hkr-ypt/iv-dcy/hardware/bom/iv_dcy-bom.csv

Reference | Value | Footprint | MPN | Qty
C1,C5 | 1uF | Capacitor_SMD:C_0603_1608Metric | 0603 1uF 16V X5R | 2
C2 | 4.7uF | Capacitor_SMD:C_0603_1608Metric | 0603 4.7uF 10V X5R | 1
C3,C4,C7 | 100nF | Capacitor_SMD:C_0603_1608Metric | 0603 100nF 16V X7R | 3
C6 | 10nF | Capacitor_SMD:C_0603_1608Metric | 0603 10nF 50V X7R | 1
D1 | green | LED_SMD:LED_0603_1608Metric | 0603 green LED | 1
J1 | USB_C_Receptacle | Connector_USB:USB_C_Receptacle_GCT_USB4105-xx-A_16P_TopMnt_Horizontal | GCT USB4105-GF-A | 1
J2 | SWD | Connector_PinHeader_1.27mm:PinHeader_2x05_P1.27mm_Vertical | Samtec FTSH-105-01-L-DV (or equivalent) | 1
R1,R2 | 5.1k | Resistor_SMD:R_0603_1608Metric | 0603 5.1k 1% | 2
R3 | 10k | Resistor_SMD:R_0603_1608Metric | 0603 10k 1% | 1
R4 | 1k | Resistor_SMD:R_0603_1608Metric | 0603 1k 1% | 1
SW1 | BOOT | Button_Switch_SMD:SW_SPST_B3U-1000P | Omron B3U-1000P | 1
U1 | STM32F042K6T6 | Package_QFP:LQFP-32_7x7mm_P0.8mm | STMicroelectronics STM32F042K6T6 | 1
U2 | MCP1700-3.3 | Package_TO_SOT_SMD:SOT-23 | Microchip MCP1700T-3302E/TT | 1
U3 | USBLC6-2SC6 | Package_TO_SOT_SMD:SOT-23-6 | STMicroelectronics USBLC6-2SC6 | 1
