hkr-ypt/iv-dcy/hardware/docs/iv_dcy-schematic.pdf

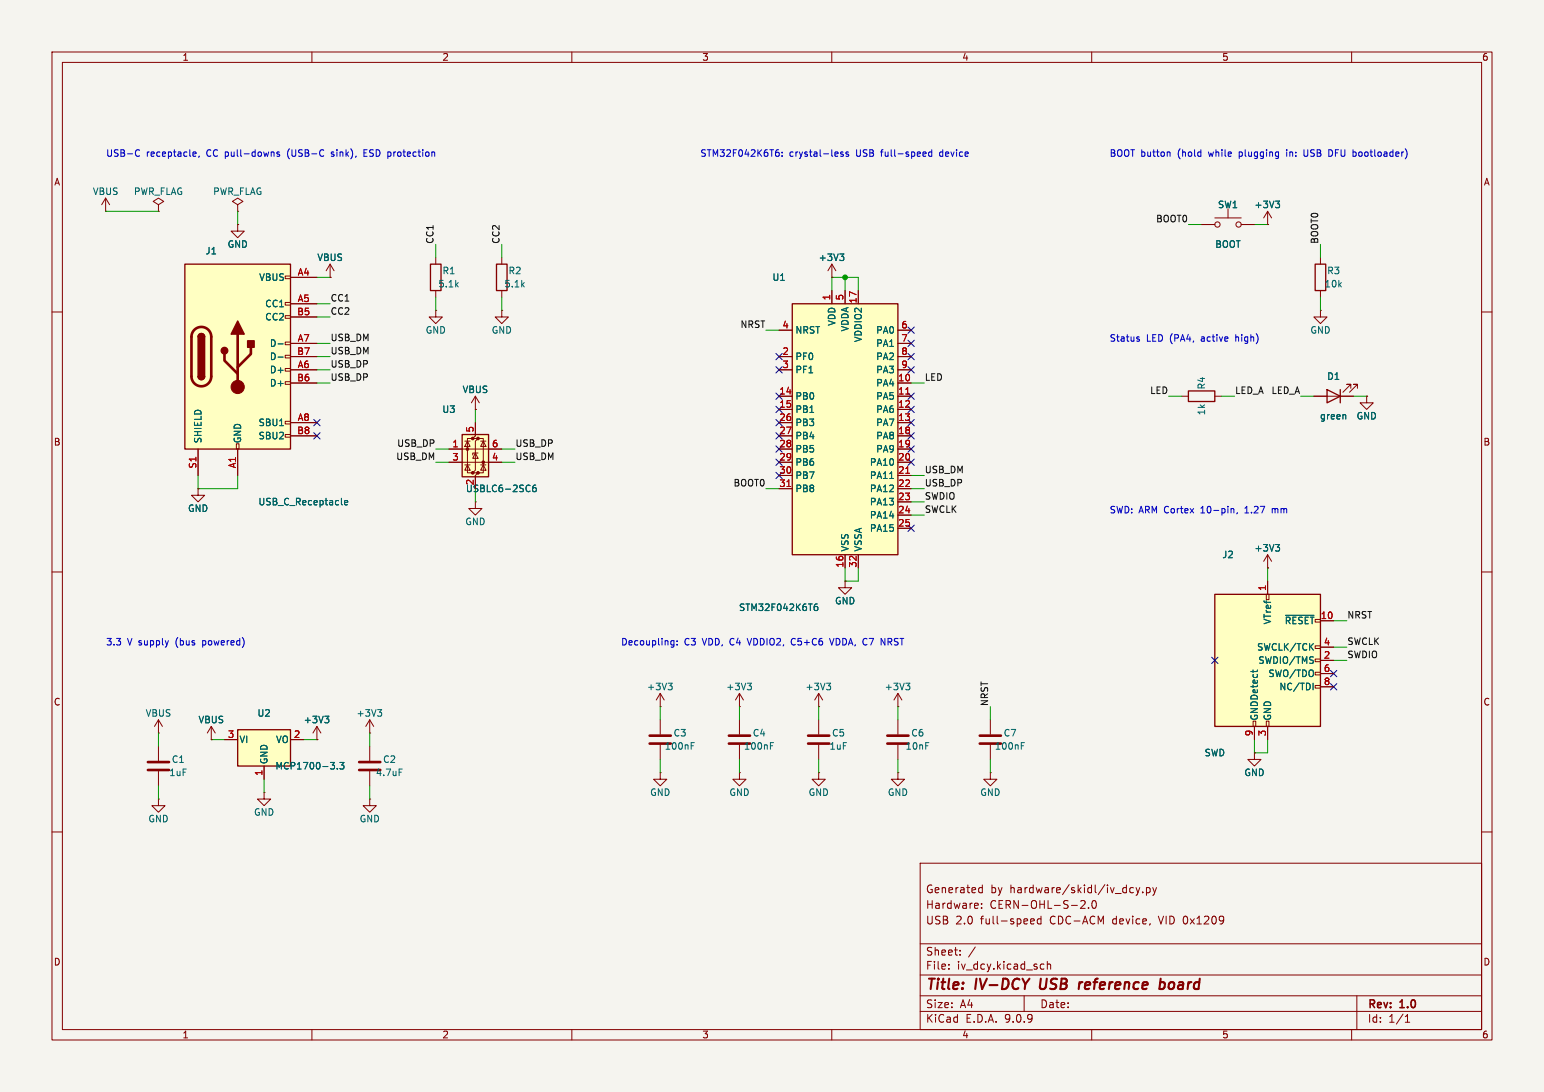
[picture p2: page 1]

3 ~{RESET}10 SWCLK/TCK 4 SWDIO/TMS 2 SWO/TDO 6 NC/TDI 8 GND

3 ~{RESET}10 SWCLK/TCK 4 SWDIO/TMS 2 SWO/TDO 6 NC/TDI 8

Id: 1/1 Title: IV-DCY USB reference board
