hkr-ypt/iv-dcy/hardware/kicad/iv_dcy.kicad_pcb

## KiCad design hardware/kicad/iv_dcy.kicad_pcb (2026-11-02)

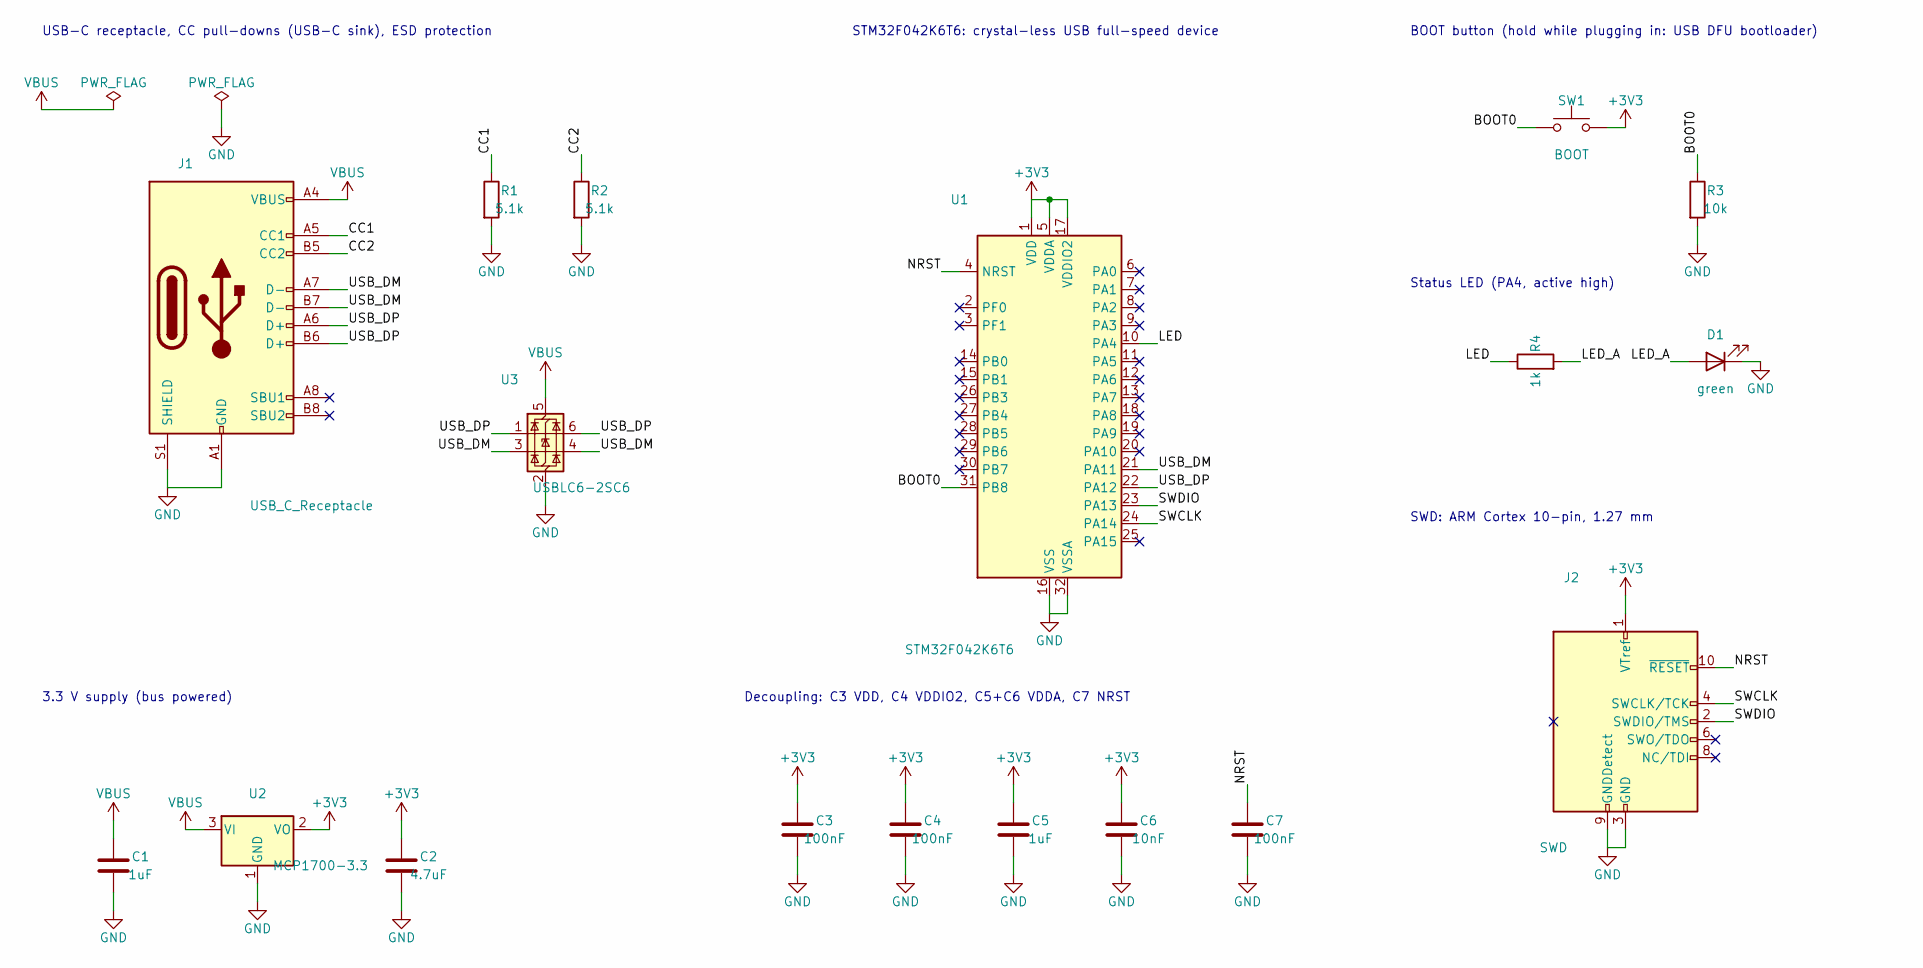
[picture p3: schematic iv_dcy.kicad_sch, IV-DCY USB reference board]

Parts:
C1, C5: 1uF; C_0603_1608Metric; MPN 0603 1uF 16V X5R
C2: 4.7uF; C_0603_1608Metric; MPN 0603 4.7uF 10V X5R
C3, C4, C7: 100nF; C_0603_1608Metric; MPN 0603 100nF 16V X7R
C6: 10nF; C_0603_1608Metric; MPN 0603 10nF 50V X7R
D1: green; LED_0603_1608Metric; MPN 0603 green LED
J1: USB_C_Receptacle; USB_C_Receptacle_GCT_USB4105-xx-A_16P_TopMnt_Horizontal; MPN GCT USB4105-GF-A
J2: SWD; PinHeader_2x05_P1.27mm_Vertical; MPN Samtec FTSH-105-01-L-DV (or equivalent)
R1, R2: 5.1k; R_0603_1608Metric; MPN 0603 5.1k 1%
R3: 10k; R_0603_1608Metric; MPN 0603 10k 1%
R4: 1k; R_0603_1608Metric; MPN 0603 1k 1%
SW1: BOOT; SW_SPST_B3U-1000P; MPN Omron B3U-1000P
U1: STM32F042K6T6; LQFP-32_7x7mm_P0.8mm; MPN STMicroelectronics STM32F042K6T6
U2: MCP1700-3.3; SOT-23; MPN Microchip MCP1700T-3302E/TT
U3: USBLC6-2SC6; SOT-23-6; MPN STMicroelectronics USBLC6-2SC6

Connections:
+3V3: C2.1, C3.1, C4.1, C5.1, C6.1, J2.1 (VTref), SW1.2, U1.1 (VDD), U1.5 (VDDA), U1.17 (VDDIO2), U2.2 (VO)
/BOOT0: R3.1, SW1.1, U1.31 (PB8)
/CC1: J1.A5 (CC1), R1.1
/CC2: J1.B5 (CC2), R2.1
/LED: R4.1, U1.10 (PA4)
/LED_A: D1.2 (A), R4.2
/NRST: C7.1, J2.10 (~RESET), U1.4 (NRST)
/SWCLK: J2.4 (SWCLK/TCK), U1.24 (PA14)
/SWDIO: J2.2 (SWDIO/TMS), U1.23 (PA13)
/USB_DM: J1.A7 (D-), J1.B7 (D-), U1.21 (PA11), U3.3 (I/O2), U3.4 (I/O2)
/USB_DP: J1.A6 (D+), J1.B6 (D+), U1.22 (PA12), U3.1 (I/O1), U3.6 (I/O1)
GND: C1.2, C2.2, C3.2, C4.2, C5.2, C6.2, C7.2, D1.1 (K), J1.A1 (GND), J1.A12 (GND), J1.B1 (GND), J1.B12 (GND), J1.S1 (SHIELD), J2.3 (GND), J2.5 (GND), J2.9 (GNDDetect), R1.2, R2.2, R3.2, U1.16 (VSS), U1.32 (VSSA), U2.1 (GND), U3.2 (GND)
VBUS: C1.1, J1.A4 (VBUS), J1.A9 (VBUS), J1.B4 (VBUS), J1.B9 (VBUS), U2.3 (VI), U3.5 (VBUS)

Notes on the sheet:
USB-C receptacle, CC pull-downs (USB-C sink), ESD protection
3.3 V supply (bus powered)
STM32F042K6T6: crystal-less USB full-speed device
Decoupling: C3 VDD, C4 VDDIO2, C5+C6 VDDA, C7 NRST
BOOT button (hold while plugging in: USB DFU bootloader)
Status LED (PA4, active high)
SWD: ARM Cortex 10-pin, 1.27 mm

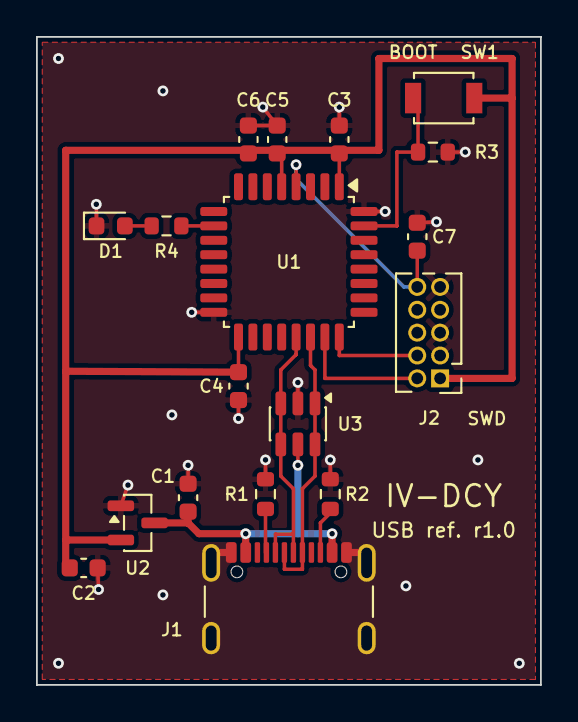
[picture p4: board iv_dcy.kicad_pcb from above]

Board: 2 copper layers, 28.0 x 36.0 mm, 18 parts (0 on the bottom side), 13 nets.
