hkr-ypt/iv-dcy/firmware/src/tusb_config.h

/* SPDX-License-Identifier: MIT
 * Copyright (c) 2026 Lucas Wu
 *
 * TinyUSB configuration: device only, full speed, one CDC-ACM interface,
 * no RTOS.  The STM32F042's USB block is TinyUSB's "stm32_fsdev" driver.
 */
#ifndef TUSB_CONFIG_H
#define TUSB_CONFIG_H

#ifndef CFG_TUSB_MCU
#define CFG_TUSB_MCU OPT_MCU_STM32F0   /* host unit tests override this */
#endif
#define CFG_TUSB_OS            OPT_OS_NONE
#define CFG_TUSB_DEBUG         0
#define CFG_TUSB_MEM_SECTION
#define CFG_TUSB_MEM_ALIGN     __attribute__((aligned(4)))

#define CFG_TUD_ENABLED        1
#define CFG_TUD_MAX_SPEED      OPT_MODE_FULL_SPEED
#define CFG_TUD_ENDPOINT0_SIZE 64

#define CFG_TUD_CDC            1
#define CFG_TUD_MSC            0
#define CFG_TUD_HID            0
#define CFG_TUD_MIDI           0
#define CFG_TUD_VENDOR         0

#define CFG_TUD_CDC_RX_BUFSIZE 64
#define CFG_TUD_CDC_TX_BUFSIZE 256
#define CFG_TUD_CDC_EP_BUFSIZE 64

#endif /* TUSB_CONFIG_H */
